LunarEchoo56/LuminaBlossom/enclosure/README.md

# Enclosure Manufacturing Files: LuminaBlossom Programmable Light Display

This folder contains the vector graphics files required to cut out LuminaBlossom's circular wooden base. These files are intended for cutting 3mm birch plywood or basswood. They were tested on an XTool D1 Pro 5W laser cutter/engraver. For your convenience, both the original XTool Studio (.xs) as well as color-coded vector graphics (.svg) files are enclosed.

## Licensing
All design assets in this folder are licensed under the Creative Commons Attribution 4.0 International License (CC BY 4.0).

## Files Included

* `luminablossom.svg` - Universal vector format for use with any laser cutter software (LightBurn, Glowforge, etc.).
* `luminablossom.xs` - xTool Studio project file, including settings used for the photographed prototypes.

## Assembly Instructions

Materials required, prep, and finishing details are available in the `\docs` folder:

* [Complete Assembly Guide](/docs/assembly.md)
