LunarEchoo56/LuminaBlossom/docs/scraps/original_spec.md

# Project Name: **LuminaBlossom** Ambient Light Display

## Functional Requirements Document

## Target Platform: Raspberry Pi Pico 2 W (Pico C SDK / Earle Philhower Core)

## Document Version: 1.1

### 1. System Overview

LuminaBlossom is a network-attached, programmable ambient light display built into a translucent lotus-blossom art piece. The system leverages the Raspberry Pi Pico 2 W (powered by an RP2350 microcontroller) to serve as a headless, Wi-Fi-enabled peripheral. It exposes a local REST API that allows external clients (such as local AI agents, VS Code extensions, or mobile applications) to trigger pre-configured or math-scripted illumination patterns.

### 2. Hardware & Electrical Requirements

#### 2.1 Power Architecture

Input Voltage: 5V DC via a Micro-USB connector.
LED Power Rail: The NeoPixel RGBW LED ring must be powered directly from the VBUS pin (5V line straight from USB power) to support peak current draws up to 1A at full brightness.
Microcontroller Power Rail: The Pico W will be powered via its internal regulator connected to VSYS.

#### 2.2 Physical Escape Hatch (Factory Reset)

The enclosure must feature a precision pinhole perfectly aligned with the Pico's native BOOTSEL button (or a dedicated hardware reset pin).
Behavior: Holding this button down via a paperclip for 5 seconds during operation will clear all stored network configurations from non-volatile memory and reboot the device back into provisioning mode.

### 3. Firmware Architecture & State Machine

The firmware will be written in C/C++ using the native Raspberry Pi Pico SDK and the lwIP (Lightweight IP) stack. To ensure smooth, stutter-free animations, the dual-core architecture of the RP2350 will be utilized.

#### 3.1 Core Allocation

Core 0: Runs the lwIP TCP/IP stack, handles Wi-Fi connections, manages the background HTTP/DNS servers, and parses incoming JSON network packets.
Core 1: Runs the math-based animation execution engine and feeds data to the PIO (Programmable I/O) state machines driving the NeoPixels.
Inter-Core Communication: Thread-safe communication will be handled using the Pico SDK’s hardware FIFO queues (pico/util/queue.h) to pass lighting state changes from Core 0 to Core 1.

#### 3.2 System State Machine

The firmware operates in two runtime modes:

- **MODE_PROVISIONING**
  Active when: no stored credentials, authentication failure, or network unreachable at boot.
  Behavior: Hosts a captive portal Access Point (LuminaBlossom_Setup). Onboard LED blinks slowly. Credentials stored in LittleFS are preserved unless the failure was an explicit authentication rejection (`WL_CONNECT_FAILED`).

- **MODE_CONNECTED**
  Active when: device successfully joins the stored network.
  Behavior: Runs WebServer on port 80, mDNS at luminablossom.local, and the NeoPixel animation engine.

**Boot sequence:**
1. Load credentials from LittleFS.
2. If credentials exist, attempt connection (20-second timeout).
3. On success → MODE_CONNECTED.
4. On authentication failure (`WL_CONNECT_FAILED`) → clear credentials → MODE_PROVISIONING.
5. On network unreachable (timeout, SSID not found) → **keep credentials** → MODE_PROVISIONING. A subsequent power cycle will retry the stored credentials automatically.

**WiFi watchdog (MODE_CONNECTED only):**
If `WiFi.status()` leaves `WL_CONNECTED`, the device reboots after a 30-second grace period, which resets the lwIP stack cleanly and re-enters the boot sequence above. Core 1 (NeoPixel animation) is unaffected during the wait.

**Factory reset:**
Holding the BOOTSEL button for 5 seconds at any time clears stored credentials and reboots to MODE_PROVISIONING.

### 4. Headless Wi-Fi Setup & Provisioning Portal

When the device cannot find valid Wi-Fi credentials in its local storage, it must automatically host a local captive portal setup experience.

#### 4.1 Access Point (AP) Mode

The Pico W will initialize the CYW43439 wireless chip in Access Point mode.
SSID: LuminaBlossom_Setup_XXXX (where XXXX represents the last 4 digits of the chip's unique MAC address).
Security: Open (No password required for initial setup).
Local IP Configuration: Gateway set statically to 192.168.4.1.

#### 4.2 Rogue DNS Server (Captive Portal Enforcement)

A lightweight UDP server must listen on Port 53.
Behavior: The server must intercept all incoming DNS lookups generated by the connecting smartphone or operating system (e.g., Apple's captive network assistant tests) and return 192.168.4.1 as the resolved IP address. This forces the client device to automatically pop open the configuration webpage.

#### 4.3 HTTP Provisioning Web Server

An HTTP server must listen on TCP Port 80.
A catch-all route must serve a single, highly optimized HTML/CSS/JS page embedded directly inside the firmware flash memory as a static byte array.

The page must:
Trigger an async scan of local Wi-Fi networks and display them in a dropdown.
Provide a secure password text field.
Issue an HTTP POST request back to the Pico containing the chosen SSID and Password.

#### 4.4 Non-Volatile Storage (Credentials)

Wi-Fi credentials (SSID and password) are stored in LittleFS at `/wifi_creds.txt` (SSID on line 1, password on line 2). LittleFS occupies a dedicated 2 MB partition of the Pico's flash.

Credential lifecycle:
- Written when the user submits the provisioning form.
- Read on every boot to attempt automatic reconnection.
- **Cleared only on explicit authentication failure** (`WL_CONNECT_FAILED`) or factory reset — never on a simple network-unavailable failure, so a device that loses its network connection temporarily will reconnect automatically on its next boot without requiring the user to re-enter credentials.

Once credentials are saved, the device executes a deferred software reboot (~1.5 s) to transition into the connecting sequence.

### 5. Network Services & Local Discovery (mDNS)

To eliminate the need for users to discover the device's IP address through their router settings, LuminaBlossom must support zero-configuration networking.

mDNS Daemon: The firmware must compile and initialize the lwIP mDNS app layer.
Local Hostname: The device will register on the local network as luminablossom.local.
Service Broadcasting: It will broadcast an _http._tcp service on port 80, allowing local discovery applications, IDE extensions, or agent scripts to automatically resolve its IP address over the network.

### 6. REST API & Interoperability Specification

Once active on the local network, the HTTP server on Core 0 will process incoming commands. All endpoints must parse and return standard JSON payloads.

#### 6.1 CORS (Cross-Origin Resource Sharing) Compliance

To allow web-based dashboards or browser extensions to communicate directly with LuminaBlossom, the HTTP response parser must include the following headers in every response, including handling the pre-flight HTTP OPTIONS method:

HTTP
```
Access-Control-Allow-Origin: *
Access-Control-Allow-Methods: POST, GET, OPTIONS
Access-Control-Allow-Headers: Content-Type
```

#### 6.2 API Endpoints

- POST /api/effect
Triggers an immediate, non-blocking visual effect.
Payload Schema:
JSON
```
{
  "effect": "string",       // Name of the preset handler (e.g., "pulse", "wave", "sparkle")
  "color": "string",        // Hexadecimal string for GRBW values (e.g., "FF000000" for Red)
  "speed": 0.00,            // Floating point modifier for time increments / frequencies
  "duration": 0             // Optional millisecond cutoff (0 for infinite loop until next command)
}
```
Success Response: 200 OK with JSON {"status": "success", "playing": "effect_name"}

- POST /api/save
Saves a custom parameter packet to the internal file storage (using a lightweight library like LittleFS embedded in flash) so it can be referenced later by a custom keyword.
Payload Schema:
JSON
```
{
  "name": "string",         // Keyword to register the effect
  "config": {               // Custom math parameters passed to the engine
    "frequency": 0.33,
    "amplitude": 1.00,
    "wave_type": "sine"
  }
}
```
Success Response: 201 Created

- GET /api/status
Returns the current health, network strength (RSSI), and active lighting pattern of the device.
Success Response: 200 OK with system statistics.

### 7. Lighting Control Engine (High-Level Placeholder)

Animation Player: Core 1 will monitor a shared state structure populated by the REST API.

Math-Scripting Interpreter: When a command is received, Core 1 will use the provided parameters (frequency, wave type, speed modifiers) to compute individual LED brightness matrices on the fly, feeding them continuously into the PIO hardware buffers at a target framerate of 60 FPS. Network calls will not block or hitch these frame calculations.
