LunarEchoo56/LuminaBlossom/docs/pio_state_machines.md

# PIO State Machines: LuminaBlossom Programmable Light Display

As described in the [LED Technical Details](/docs/led_technical_details.md#4-taking-advantage-of-the-pico), our Raspberry Pi Pico 2 has a bank of 12 "Programmable I/O" state machines, or "PIOs." Our hardware is built to control a lot of devices, some of which (like our LED lights!) require specific signal timing. These little state machines are like tiny processors of their own that run independently of the main CPUs. They're perfect for sending messages or instructions between different parts of the computer while our powerful processors are doing something else.

Our LED lights are controlled by a single data line that requires super-specific signal timing, sending a "1" or a "0" every 1.25 microseconds. Any interruption in our data stream might corrupt the data. Rather than use a CPU to babysit the signal, this is a textbook example of what the PIO state machines are made for! In the LuminaBlossom, one of our CPUs (core 1 in this case) calculates the next frame of animation data and drops all of the color information into the PIO's buffer. The CPU is free to move on to other tasks while a PIO state machine dutifully converts the data into a perfectly-timed signal that it sends to the lights, 1.25 microseconds for each and every 1 or 0, until the data is sent.

For more details about how the lights work, see the [LED Technical Details](/docs/led_technical_details.md). In this section, we're going to look at the PIO and how we coded it.

>[!TIP]
>Understanding the PIO state machines is an incredible exercise for a computer scientist! This is pure bits and steel. It's machine-code in action. Learning how PIO state machines work demonstrates how _computers_ work at the lowest level. Let's do it!

---

## Table of Contents

1. [The Hardware](#1-the-hardware)
2. [PIO Machine Language](#2-pio-machine-language)
3. [Our LED Code](#3-our-led-code)
4. [Assembly](#4-assembly)
5. [Getting Started and Further Reading](#5-getting-started-and-further-reading)

---

## 1. The Hardware

To understand what's happening inside the hardware, let's shrink ourselves down to computer-size! Imagine that you are in a small workshop. Looking around, here's what you see:
- A mailbox on the wall for incoming mail
- A mailbox on the wall for outgoing mail
- A simple clock with only one hand and only one number
- A big instruction book, with a bookmark reserved just for you
- A little shelf big enough to hold a number, labelled "Scratch X"
- An identical little shelf labelled "Scratch Y"
- One or more Big Important Switches on the back wall
- A Very Important bright red telephone labelled "IRQ"

                ┌──────────────────────────────────────────────────────────────────────────────────┐
                │ \                                                                              / │
                │  ┌────────────────────────────────────────────────────────────────────────────┐  │
                │  │                                                                            │  │
                │  │  <== TO CPU                                              TO GPIO PINS ==>  │  │
                │  │                                                                            │  │
                │  │                                  _______                                   │  │
                │  │                                 ( CLOCK )                                  │  │
                │  │                                  -------                                   │  │
                │  │                                                                            │  │
                │  │   ┌──────┐   ┌──────┐                                                Big   │  │
                │  │   │INBOX │   │OUTBOX│                          │X Scratch           Switch──┐ │
            Red │┌─┐   │      │   │      │                          ├──────────               │ │├─┴────
            Phone│IRQ  ┌──────┐   ┌──────┐    Instruction   YOU     │Y Scratch               /│ ││ GPIO
                │└─┘   └──────┘   └──────┘       Book     (A PIO)   └───────────            O │ │├─┬────
                │  │                          ┌─────────┐    o                                └──┘ │
                │  └──────────────────────────└─^───────┘───└█┘─────────────────────────────────┘  │
                │ /                            Bookmark     / \                                  \ │
                │/                                                                                \│
                └──────────────────────────────────────────────────────────────────────────────────┘

Congratulations, you're a PIO state machine! Your job is super-simple. The clock is spinning at a constant rate. Whenever it dings, you go to the instruction manual, execute the instruction given at your bookmark, then scoot your bookmark forward to the next instruction. There are less than a dozen possible instructions, and every instruction is SUPER simple, like:

- "Grab a number from your inbox and put it onto the Scratch X shelf."
- "Move your bookmark to a different page."
- "Copy the contents of Scratch Y to your Out-box."
- "Pick up the Red IRQ Phone and push 0!"

As a PIO, you're not even expected to do _math!_ For the most part, you pretty much just conditionally move data around and flip switches.

**PIOs Operate Independent of the CPU**

From the perspective of the computer, every PIO workshop is self-operating. The CPU drops off the instruction book, sets the bookmark, sets the clock speed, and then leaves the PIO alone to run those instructions until someone tells it to stop or the computer blows up.

The giant red "IRQ" phone is an exception, used for communicating directly between the PIO and CPU. "IRQ" stands for "Interrupt Request" and the CPU can be programmed to drop whatever it's doing and handle that request immediately. This is expensive and potentially disruptive to the CPU, which is why I describe it as a red phone. The phone works both ways - the CPU can make the phone ring, and the PIO will respond _if its instructions call for it._ One example might be "wait here until the red phone rings," or "jump to this instruction if the red phone is ringing."

**PIOs Directly Operate the GPIO Pins**

What I described as "important switches on the back wall" are the GPIO ("General-Purpose Input/Output") pins of the Raspberry Pi Pico 2W. The Pico is a microcontroller, which means its job is to control stuff. In this case, we're controlling a string of LED lights from GP16 (pin 21 on the corner of the device - See the [Wiring Guide](/docs/assembly.md#6-wiring-the-pico-2w)). Our PIO will flip this switch "on" and "off" to send color data out to the LEDs. In our setup, _only_ the PIO has access to this pin. If we want the lights to do something, we need to tell the PIO!

Our "LED Controller" PIO program is very simple and only uses one pin: It'll read data one bit at a time from the inbox, then toggle the LED data pin on and off with exact timing. It's a super-simple job, and our little machine will do it non-stop. 32 bits of data per light, times 16 lights, 60 times a second... That's 30,720 bits of data processed every _second_. Go little machine, go!

---

# 2. PIO Machine Language

Let's take a close look at what I described as a big "instruction book" with a personal bookmark. As with everything else in a computer, the instructions are saved as a bunch of ones and zeroes, stored in memory. What I described as a "bookmark" is called the "Program Counter," and it's really just a pointer to the memory address of the instruction you're on.

Think _small_. The entirety of the instruction book is only 64 bytes. That's 512 bits. This paragraph of text is more than twice that size!

Every complete instruction for the PIO is represented in only 16 bits. Below you'll find a table of all the possibilities, and how the 16 bits are used. As you can see, every single 1 or 0 makes a difference! There's a whole 5-bit section (called "Delay / Side-set") that we can customize to squeeze even more operations out of every bit:

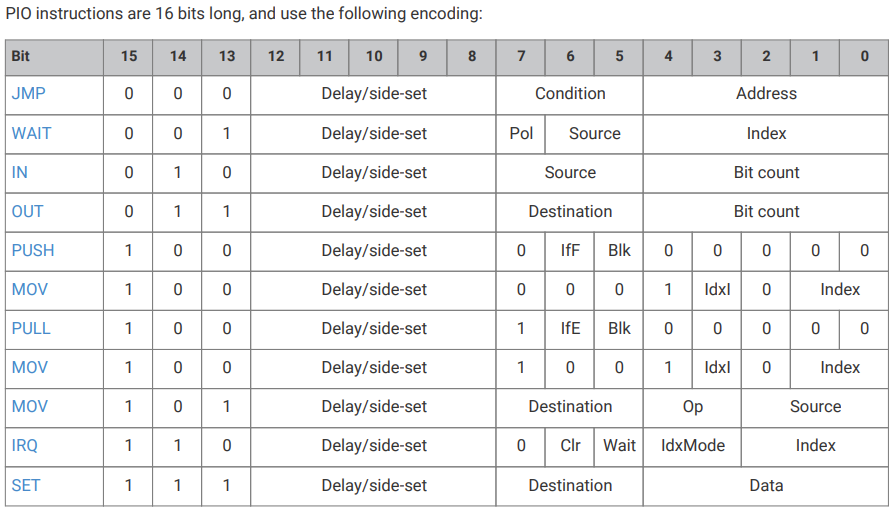
[picture p12: docs/images/pio_instructions.png]
PIO State Machine Instructions


Don't sweat all the details yet - learning all of these instructions and how they work would make you a true machine language programmer! The really important thing to understand right now is _how_ it works: The PIO uses just a few ones and zeroes to perform any action. Let's just look at one example!

PIO State Machine "Wait" Instruction

Your PIO starts reading an instruction and sees that the first three bits are "001." That means "Wait," so the remainder of the bits are going to tell the PIO how long to wait and what to wait on. The next five bits are customizable when we set up the machine, we'll talk about them in a second. The next bit (labelled 7) stands for the "polarity" - in other words, are we waiting for a 1? Or are we waiting for a 0? Bits 5 and 6 together tell us the "source" we're waiting on. For instance, if these two bits are "00" that means we're waiting on one of the GPIO pins, and the next five bits (labelled 0-4) will tell us which one. If bits 5 and 6 are "10" that means we're waiting on an IRQ (in our analogy above, this is like checking the status of the "Red Phone" to the CPU...)

How do we know this stuff? Each and every bit is labelled and described in the [Datasheet for our CPU](https://datasheets.raspberrypi.com/rp2350/rp2350-datasheet.pdf). It takes about a page to describe the workings of each instruction.

## Customizing Your Instructions: Delays and Side-Sets

When we first set up a PIO state machine, in addition to writing the instruction book and setting the clock speed, we can also tell the machine how to interpret those five "Delay / Side-Set" bits.

By default, all five bits are used to calculate a delay - that is, a number of cycles the machine waits after completing the instruction before moving on to the next one. Five bits can hold a number between 0 and 31 - in other words, if all the bits are 0s, we don't delay at all, and execute the next instruction on the next clock cycle. If all five bits are 1s, then we delay 31 cycles before advancing.

>[!Tip]
>Since we can set the clock timing to whatever we want (up to the clock speed of the CPU), we can precisely time our delays. Even without overclocking the Pico 2W we can set the clock cycles to be as fast as 6.7 _nanoseconds_ per tick. These machines are built to be fast and precise!

But if we don't need a full 31-cycle delay anywhere in our program, we can sacrifice some of those "delay" bits to "side-set" a pin. The engineers who designed the system thought about it this way: One of the most important things a PIO will do is toggle a GPIO pin on or off. Rather than waste a full instruction every time we want to do that, we assign some of those bits to setting a pin on or off in addition to whatever the main instruction is. Hence the name, "side-set."

By establishing a side-set pin when you initialize a state machine, you can "double-up" your instructions. For example, "JUMP here (and also turn the pin on)", "MOVE this (and turn the pin off)." Our state machine only has the memory for 32 instructions, so by packing in the instructions like that we can maximize the effectiveness of every bit.

## Now You're Speaking Machine!

Obviously it would take a long time to explain every bit of every instruction, but if you understand the concept, you have just learned how computers work at a fundamental level. Your state-of-the-art desktop CPU uses more than 16 bits per instruction, but it still processes instructions with each cycle. It has a great many more operations it can do, and scratch registers to do them on, but it's still moving numbers around between registers and into or out of memory. Any non-quantum computer _fundamentally works the same way as a PIO state machine_, converting _bits_ into _instructions_ and doing them according to a set clock cycle.

If you understand what's happening down there in binary, you understand the very principle of how computers operate. Congratulations! In this day and age of vibe-coding, very few humans actually comprehend what's going on at this machine level, and fewer still know how to program there.

>[!Note]
>That's why I wanted to make sure PIO-coding was a part of this project. These little machines are a perfect demonstration of machine code in action, and you can play around in this space on a computer that costs less than a cheeseburger combo.

---

# 3. Our LED Code

As we've seen in the [LED Technical Details](/docs/led_technical_details.md), we're using "SK6812" RGBW LEDs, which share the same data/timing specs as "WS2812" LEDs. That means our LEDs are programmed via a single data line that must transmit bits at a fixed clock speed. If we listened in on the data line while it was transmitting, an oscilloscope would show something like this:

                        One bit is sent every 1.25 microseconds.
    │          Divide that time into 10 "Cycles" of .125 microseconds each.        │
    ├──────┬───────┬───────┬───────┬───────┬───────┬───────┬───────┬───────┬───────┤
    │      │       │       │       │       │       │       │       │       │       │

                  A "1" is a HIGH pulse of 7 cycles and a LOW pulse of 3.
    │███████████████████████████████████████████████████████       │       │       │
    ├──────┬───────┬───────┬───────┬───────┬───────┬───────────────┴───────┴───────┤
    │      │       │       │       │       │       │        ███████████████████████│

                  A "0" is a HIGH pulse of 2 cycles and a LOW pulse of 8.
    │██████████████        │       │       │       │       │       │       │       │
    ├──────┬───────────────┴───────┴───────┴───────┴───────┴───────┴───────┴───────┤
    │      │       ████████████████████████████████████████████████████████████████│

                              Here's another way to look at it:

    │ Always High  │       DATA: High for 1, Low for 0     │      Always Low       |
    │██████████████│░░░░░░░│░░░░░░░│░░░░░░░│░░░░░░░│░░░░░░░│       │       │       │
    ├──────┬───────┼───────┼───────┼───────┼───────┼───────┼───────┴───────┴───────┤
    │      │       │░░░░░░░│░░░░░░░│░░░░░░░│░░░░░░░│░░░░░░░│███████████████████████│

Put simply, the PIO just has to flip the data pin on or off and wait a specified period of time. For each bit, we flip the data line HIGH for two cycles. If the bit is a "1" we keep the data line HIGH for the next five cycles, whereas for a "0" we turn the data line LOW for five cycles. In either case we set the line LOW for the final three cycles, and then begin again.

My original PIO code is below. The header and comments are in MicroPython format, but what you want to pay attention to are the last 9 lines. Those are written in "Assembly," a kind of human-readable shorthand for machine code. (Technically it's a python-readable syntax of assembly.)

    @rp2.asm_pio(sideset_init=rp2.PIO.OUT_LOW, out_shiftdir=rp2.PIO.SHIFT_LEFT, autopull=True, pull_thresh=32)
    def neopixel_projector():
        """
        Waits for a stream of colors from the main program and sends them to the
        NeoPixel with precise timing. WS2812B timing constants: Each "pulse" is
        0.125 microseconds (us). Total signal is 10 pulses / 1.25 us.
        Run this machine at 8MHz (freq=8000000) for microsecond-perfect timing!
        """
    # To send a "1", we need a high pulse of 7 cycles (2 + 5) and a low pulse of 3 cycles (3).
    # To send a "0", we need a high pulse of 2 cycles (2) and a low pulse of 8 cycles (5 + 3).
    # Each bit will always last 10 cycles (2 + 5 + 3).

    wrap_target()                           // Start here
    label("bitloop")                        // Jump target "bitloop"
    out(x, 1)               .side(0) [2]    // Grab the next bit, put it in "X". Pin: LOW, delay 2
    jmp(not_x, "do_zero")   .side(1) [1]    // Jump to "do_zero" if X is zero. Pin: HIGH, delay 1
    label("do_one")                         // Label. We're outputting a 1 next line
    jmp("bitloop")          .side(1) [4]    // Jump back up to "bitloop." Pin: HIGH, delay 4 [Data]
    label("do_zero")                        // Jump target "do_zero." We're outputting a 0 next line
    nop()                   .side(0) [4]    // Do nothing... But: Pin: LOW, delay 4 [Data]
    wrap()                                  // Go back to start

If we focus on the assembly code, we see at least half of it is labels and jumps. The line where the rubber meets the road is this one:

    out(x,1)                .side(0) [2]

It says, "grab exactly 1 bit from the 'Output shift register' and put it into our 'x register.'"

>[!TIP]
>The Output Shift Register is one of those mailboxes that I described earlier. The MicroPython header at the top ("out_shiftdir=rp2.PIO.SHIFT_LEFT, autopull=True, pull_thresh=32") defines how our PIO should handle its mailbox: Every time we run out of bits we grab 32 more.

Many lines in the code say ".side(0)" or ".side(1)". This is that sweet side-setting functionality described above: When we start our PIO machine, we'll tell it that its side-set pin is the data line for our lights. .side(1) sets the line high, .side(0) sets it low.

A number in brackets also appears in many lines. This is the number of cycles to delay _after_ executing the instruction. Note that it always takes _one_ cycle to perform an instruction, so to wait for exactly five cycles we would run an instruction and then delay four. This is what happens in the "do_one" or "do_zero" section of the code: We set the pin to high or low, then delay 4 cycles (for a total time of 5).

See if you can follow along with the code as it processes either a 1 or a 0!

---

# 4. Assembly

We have our list of instructions above written in a (python-readable) shorthand called "Assembly Language." For it to run on our PIO state machine, we have to convert those instructions into the binary 1s and 0s that we talked about in [Section 2](#2-pio-machine-language). Every instruction has to be converted into 16 bits, and every label/jump destination has to be converted into a relative memory address. We call this process "Assembly" and the programs that do it "Assemblers."

The PIO state machines are simple enough that we can imagine doing this by hand. The relevant section of the [RP2350 Datasheet](https://datasheets.raspberrypi.com/rp2350/rp2350-datasheet.pdf) is only about a dozen pages. Similar to the way we broke down the "WAIT" instruction above, you could figure it out, line-by-line, one 16-bit instruction at a time. Once you take out all the jump targets or labels, you really only have about 4 lines of code. It's an interesting exercise for a student. It takes you back to a time when programs were entered into the front panel of a computer by manually flipping switches! But as you'd imagine, nobody really "hand assembles" anything anymore.

The designers of the Raspberry Pi Pico 2W provide an SDK that includes something called the "pioasm" (PIO Assembler). This takes raw assembly code and outputs a C header (.h) file with the complete machine configuration and code. Using this, your C program can initialize a PIO state machine with ease. Other people have written other tools that do the compiling for you: the code above was written in MicroPython. MicroPython (and the related CircuitPython language) can assemble that code on the fly and upload it to your PIO when needed.

Recently, there's another way to get our final code, thanks to large language model AI. Converting this stuff to binary is a walk in the park for an advanced model, and a frontier model can convert the MicroPython code above in a single pass. The results:

    static const uint16_t ws2812_program_instructions[] = {
        //        Instruction                side  delay
        0x6221u,  // out x, 1               0     2     (pin LOW  for 3 cycles)
        0x1123u,  // jmp !x, 3  → do_zero   1     1     (pin HIGH for 2 cycles; !x = condition 001)
        0x1400u,  // jmp 0  (do_one→bitloop)1     4     (pin HIGH for 5 cycles)
        0xa442u,  // mov y, y (nop/do_zero) 0     4     (pin LOW  for 5 cycles)
    };
    static const pio_program_t ws2812_program = {
        .instructions = ws2812_program_instructions,
        .length       = 4,
        .origin       = -1,
    };

Nobody but the computer would ever need to look at that code in binary, but for super-fun (yeah, fun!) here's what that looks like in raw 1s and 0s:

    0110 0010 0010 0001     // out x, 1     0 2 (pin LOW for 3 cycles)
    0001 0001 0010 0011     // jmp !x, 3    1 1 (pin HIGH for 2 cycles)
    0001 0100 0000 0000     // jmp 0        1 4 (pin HIGH for 5 cycles)
    1010 0100 0100 0010     // nop          0 4 (pin LOW for 5 cycles)

Those 64 bits are _everything_ your PIO needs to know in order to send color data to your lights with micro-second precision timing. What a little miracle!

## Revving Up the Machine

The PIO hardware will just sit there until a CPU tells it to go. As we pointed out above, the CPU needs to set up a few things before turning that sucker loose: What are the instructions? Which instruction should it begin at? How fast should the clock cycle be? What pins are the machine connected to? How do we handle those 5 customizable delay/sideset bits? And if we're using sideset, which pin is it setting? How should it handle the inbox and the outbox?

The exact mechanics for doing all of this vary by language, and it can be extremely fiddly. In our .cpp program it's about 15 lines of code. Let's walk through it in order, starting from when the machine boots up and starts to execute `main.cpp`. The first thing Core 1 does is call initLEDs(), located in `led_controller.cpp`:

    void initLEDs() {
        // Determine "Offset," the start of our program.
        uint offset = pio_add_program(_pio, &ws2812_program);   // Add our program, note the address
        _sm = (uint)pio_claim_unused_sm(_pio, true);            // Use first available state machine
        ws2812_sm_init(_pio, _sm, offset, LED_PIN);             // Call Init function w/ our program

        _ledsEnabled = true;
    }

 Those first lines of code tell the PIO which program its going to run and calculate where the program is located (the "Offset.")

>[!TIP]
>Up to four state machines can share the same 64-byte "instruction book." It's possible to have all four machines running the same code, or it's possible to divide up the instruction book into multiple chunks and have each machine run its own code. In order for this to work, when you initialize a state machine, you have to tell it which instruction (or "page of the book") it's supposed to start on - in the code, we call this the "offset."

The data for our code is saved as "ws2812_program." We load it into our PIO data bank and note the offset. The next line claims the first unused state machine available and saves it as _sm ("state machine.") The last line calls a longer ws2812_sm_init() function to handle the nitty-gritty configuration and start the machine.

Here's what that code looks like:

    // ── PIO state machine initialization ──────────────────────────────────────────
    static void ws2812_sm_init(PIO pio, uint sm, uint offset, uint pin) {
        pio_gpio_init(pio, pin);
        pio_sm_set_consecutive_pindirs(pio, sm, pin, 1, true);  // pin is output

        // Start with Default Config and adjust for our sideset bits and data length
        pio_sm_config c = pio_get_default_sm_config();
        sm_config_set_wrap(&c, offset, offset + 3);           // wrap_target=0, wrap=3
        sm_config_set_sideset_pins(&c, pin);
        sm_config_set_sideset(&c, 1, false, false);           // 1 sideset bit, not optional
        sm_config_set_out_shift(&c, false, true, 32);         // shift left, autopull at 32 bits
        sm_config_set_fifo_join(&c, PIO_FIFO_JOIN_TX);        // 8-word TX FIFO

        // 8 MHz for WS2812-compatible timing (matches Python reference)
        float div = (float)clock_get_hz(clk_sys) / 8000000.0f;
        sm_config_set_clkdiv(&c, div);

        // Initialize machine and start it up!
        pio_sm_init(pio, sm, offset, &c);
        pio_sm_set_enabled(pio, sm, true);
    }

Essentially, we start with the default state machine configuration (pio_get_default_sm_config()), then make a few adjustments to let it know how big our program is, when it should wrap, which pins we're going to use, how we handle the five delay/side-set bits, and how we handle our mailboxes . We also set the machine to run at 8 MHz (to get the exact cycle timing for our lights). Finally, the last two lines initialize the state machine and turn it on.

If you follow the code, you can see that this is the _very_ first thing that CPU Core 1 does on start up. Sure enough, when you plug in your LuminaBlossom, note that the lights _immediately_ turn on. Our PIO state machines are running and our LEDs are operable pretty much from the instant we boot. Technology is cool!

---

# 5. Getting Started and Further Reading

Hopefully the above explanation gives you an idea of how the LuminaBlossom uses the PIO hardware to update its LEDs. These PIO state machines are simple processors, and they're really fun to play with, but you can see they require quite a bit of setup and tinkering. Don't be intimidated! The important thing is to understand _how they work_ and _what they're used for._ With that background, you should be able to crib together the functionality you need by working from existing examples or working with AI.

## Repositories of PIO Programs

* [Official Raspberry Pi PIO Sample Programs](https://github.com/raspberrypi/pico-examples/tree/master/pio/) - This well-documented collection of PIO utilities demonstrate their many uses, such as this straightforward [Squarewave Example](https://github.com/raspberrypi/pico-examples/tree/master/pio/squarewave).
* [Raspberry Pi WS2812 LED Implementation](https://github.com/raspberrypi/pico-examples/tree/master/pio/ws2812) - As you might imagine, LuminaBlossom's LED driver is based off of this. It should look pretty familiar. Good programmers copy; _Great_ programmers copy _and_ paste!

## Official Documentation

* [RP2350 Datasheet](https://datasheets.raspberrypi.com/rp2350/rp2350-datasheet.pdf) - The RP2350 is the CPU we're using. The PIO state machines are explored in extensive depth starting on page 876.
* [Raspberry Pi C/C++ SDK](https://pip-assets.raspberrypi.com/categories/609-microcontroller-boards/documents/RP-009085-KB-2-raspberry-pi-pico-c-sdk.pdf) - The complete SDK has a whole section explaining the PIO and how to code it, starting on page 35.

## Helpful Community Resources

* [LuminaBlossom's LED Technical Details](/docs/led_technical_details.md) - More about this topic from the perspective of the LED hardware and what it does with the signal we generate above.
* [Cornell University: _Digital System Design with Microcontrollers_ Course](https://ece4760.github.io/) - Professor Hunter Adams has a wonderful series of lectures and guides from Cornell posted online. It's an exceptional resource for makers.
* [Wokwi Raspberry Pi Pico Simulator](https://wokwi.com/pi-pico) - Play with a virtual Pico in your web browser! Among the many projects there's even a [Simulation of a 16-light LED Ring](https://wokwi.com/projects/314265138001609280) very similar to the LuminaBlossom. You can even click on the "PIO" tab to watch the PIO code in action.
* [Gary Explains the PIO State Machines](https://www.youtube.com/watch?v=QlKtEA5XKc4) - A friendly video explanation of the above material, with lots of examples of PIO in action.
