LunarEchoo56/LuminaBlossom/docs/assembly.md

# Physical Assembly Guide: LuminaBlossom Programmable Light Display

Building your own LuminaBlossom from scratch? Great idea! This is the perfect starter/intermediate electronics and woodworking project. All of the files you need are in this repository, and all of the hardware and skills you'll need are listed below.

---

## Table of Contents

1. [Bill of Materials](#1-bill-of-materials)
2. [Workbench Equipment](#2-workbench-equipment)
3. [Manufacturing the Case](#3-manufacturing-the-case)
4. [Prepping the Lights and Spindle](#4-prepping-the-lights-and-spindle)
5. [Prepping Your Artwork](#5-prepping-your-artwork)
6. [Wiring the Pico 2W](#6-wiring-the-pico-2w)
7. [Final Assembly](#7-final-assembly)

---

## 1. Bill of Materials

| Item | Qty | Est. Price (USD) | Vendor Ideas | Notes |
| :--- | :---: | ---: | :--- | :--- |
| **Raspberry Pi Pico 2W** | 1 | $7.00 | [Adafruit](https://www.adafruit.com/product/6087) [Microcenter](https://www.microcenter.com/product/687384/raspberry-pi-pico-2-w) | Our heroic microcontroller! Make sure to get the "2W." |
| **Adafruit NeoPixel Ring (16-pixel) RGBW** | 1 | $11.95 | [Adafruit](https://www.adafruit.com/product/2854) | Beautiful pre-assembled circular array of RGBW LEDs. I prefer warm-white. |
| **SN74AHCT125N DIP-14 buffer IC** | 1 | ~$0.75+ | [TI datasheet](https://www.ti.com/lit/ds/symlink/sn74ahct125.pdf) | Through-hole buffer used on the new carrier PCB. |
| **330 Ω axial resistor** | 1 | ~$0.10+ | General component | R1 series resistor between U1 output and LED DIN. |
| **100 nF ceramic capacitor** | 1 | ~$0.10+ | General component | C1 bypass capacitor near U1 supply pins. |
| **470 µF / 10 V radial capacitor** | 1 | ~$0.50+ | General component | C2 bulk capacitor near LED output; observe polarity. |
| **Two-layer carrier PCB** | 1 | Varies | [KiCad source](../hardware/kicad/luminablossom_carrier.kicad_pcb) | Rev A draft only; no Gerbers yet. |
| **Female 1×20 socket strip, 2.54 mm** | 2 | Varies | General component | Two Pico socket rows, 17.78 mm spacing. |
| **Male 1×3 header, 2.54 mm** | 1 | ~$0.10+ | General component | LED output: +5 V, GND, DIN. |
| **Capiz-Shell Decorative Lotus Art** | 1 | ~$10.00+ | (See notes) | Any decorative tea-light holder will work; See notes below for sourcing the beautiful capiz-shell assembly shown.  |
| **50mm Frosted-Glass Cabochon** | 1 | ~$1.50+ | [Amazon](https://www.amazon.com/dp/B07JKZP1Z6) | This acts as a diffuser to bounce our LED lights around; a 50mm translucent acrylic circle is an inexpensive alternative. |
| **3mm (1/8-in) Basswood or Birch Plywood** | 1 | ~$4.00 | Local Lumber / Craft Store | You'll need roughly 8"x12" of wood for laser cutting the case. |
| **Micro-USB Cable (3ft to 6ft)** | 1 | ~$3.00 | Generic / Amazon [Example](https://www.amazon.com/Charging-Transfer-Android-Trustable-MYFON/dp/B098DW7485/) | For power and programming. Ensure it's a data cable, not just power! |
| **5V 1A USB Power Adapter** | 1 | ~$8.00 | Generic / Amazon [Example](https://www.amazon.com/Certified-Charger-Universal-Portable-Adapter/dp/B017TXGM4I/) | Standard phone charger wall brick to power the LuminaBlossom independent of a computer. |
| **M2 Screws (6mm)** | 4 | $.40 | [Amazon](https://www.amazon.com/HVAZI-Metric-Notebook-Computer-Assortment/dp/B075C6C4YR/) / [McMaster-Carr](https://www.mcmaster.com/91698A202/) / [MicroConnectors](https://www.microconnectors.com/assorted-laptop-screws-set-250-pcs-scw-250lp/)| For securing the Pico 2W to the wooden base. |
| **#6 Wood Screws (1/2in)** | 3 | $.75 | [Amazon](https://www.amazon.com/TPOHH-Stainless-Phillips-Threaded-5x12SS18-8/dp/B092Q87W39/) / [McMaster-Carr](https://www.mcmaster.com/90031A552/) | For fastening the two halves of the base enclosure. |
| **Rubber Feet (Self-Adhesive)** | 3 | $1.00 | [Adafruit](https://www.adafruit.com/product/550) [Amazon](https://www.amazon.com/dp/B074PXFWPK/ref=twister_B092W7TL7Y) | These little guys really elevate your build. (Looks directly at camera.) |
| **TOTAL ESTIMATE** | | Recalculate | | *The previous estimate predates the carrier PCB, buffer IC, resistor and capacitors; check current supplier prices.* |

>[!TIP]
>**Sourcing a Tea-Light Holder**:
>The capiz-shell design pictured here is available from [World Market](https://www.worldmarket.com/p/capiz-20-petal-lotus-tealight-candle-holder-119956.html). These are crafted in the Philippines from local materials and look great. Anything designed for a 4cm tea-light candle should work. Try to find something with a lot of translucent surfaces for the light to play off of. Look around and see what "LuminaBlossoms" for you!

---

## 2. Workbench Equipment

To construct this project from scratch, you'll need the skills and equipment to laser-cut and prepare wood, and to solder wires onto circuit boards. If you've never done those things before, this is a _great_ project for getting started! Here's what you should have on-hand:

1. **A 5W (or Greater) Laser Engraver/Cutter.** For the best results, you'll want an air assist and a honeycomb workbench panel. A more powerful laser will cut the project faster, but a little 5W will do.

2. **Wood Prep Materials.** Wood glue and clamps are essential, but for a really pro look and feel you'll also want sandpaper (200 and 400 grit), your color choice of stain, and your choice of finish.

3. **A Soldering Iron Station.** Work in a well-ventilated area, preferably with a heat-resistant mat to protect your work surface. We're only soldering 6 connections, but they're very small: a magnifying glass and "helping hands" to hold the material will really help.

4. **Adhesive.** You'll want a way to attach the wooden parts of the LuminaBlossom to the art piece - little bit of Gorilla Glue will do the trick here. Optionally, a hot-glue gun is terrific for attaching and running hidden wires.

5. **(Optional) Metal-Drilling Equipment.** If you need to run wiring through your lighting display, you may want to drill a hole. _Use caution when drilling metal!_ Wear gloves and goggles, secure the art well, and use a stepped drill bit. LuminaBlossom needs only three small wires, so rather than risk damaging your art (or yourself!), you may just want to discretely run the wires.

---

## 3. Manufacturing the Case

The files you need for cutting and engraving the wooden case and lighting spindle are located in the `\enclosure` folder.

The Enclosure Before Prep and Assembly

Essentially, we're cutting out a "six-pack" of wooden disks. We'll glue three of these together to form the bottom half of the base with pre-printed instructions. The other three layers will be glued together to form the top half of the base, which holds the heart of the project: the blossom artwork, the lighting spindle, and the microcontroller. Once assembled and wired, we will screw both halves together to enclose the hardware and wires in a small hollow cavity.

1. **Download the Design.** Download the correct files for the hardware you're using.

- `\enclosure\luminablossom.svg` is a general-purpose file in "scalable vector graphics" format, or .svg. Import these files into your tool of choice (like LightBurn or Glowforge) and make sure your settings are correct (cut red lines, score blue lines, engrave black lines.) The .svg file features a friendly calibration cube that you can use to ensure you're cutting exactly the right size.

- `\enclosure\luminablossom.xs` is the "xTool Studio" file used for the original design and the prototypes made in the photographs. If you're using xTool hardware and like using their proprietary software, this is the file you want. The machine used was an xTool D1 Pro with a 5W laser. The settings for 3mm birch plywood should already be configured in this file, but you should still double-check the settings and scale for your machine.

2. **Laser-Cut Your Material.** The pictured build uses 3mm (1/8") birch plywood. Do some tests to make sure your configuration is spot-on.

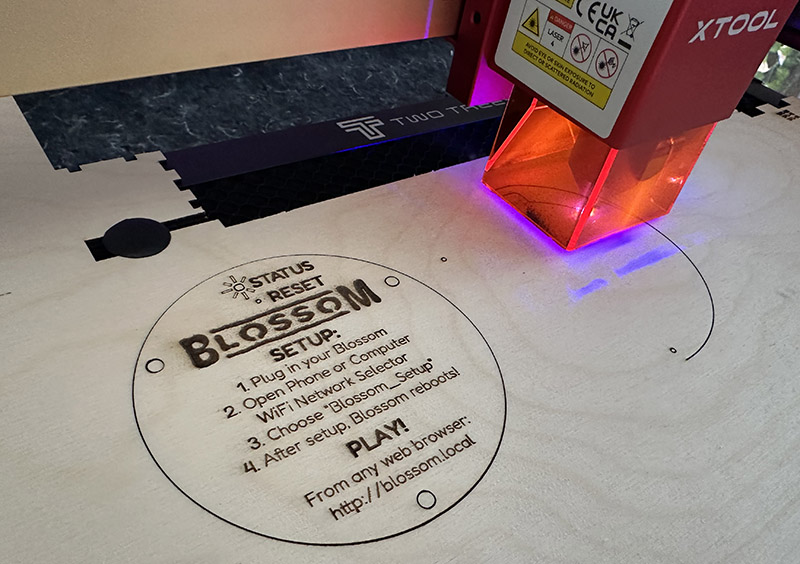
[picture p14: docs/images/laser_cutting.jpg]
Laserin'!


 You're looking for:

- Clean cuts all the way through the wood without scoring.
- An "Engrave" setting that burns in, with high contrast, things like the logo and the headers
- A "Score" setting that burns a nice clean high-contrast line without scorching the wood.

Ensure your tea-candle holder/art display fits into the round holes on top - it's easier to sand and adjust that now than it will be after assembly.

3. **Glue!** Glue the three top pieces together, making sure the nicest wood-grain you have is facing up for the top ring. Align the screw-holes and glue the bottom three pieces together, ensuring that the instructions face down. It's easy to mix up or invert these pieces, so double-check before you glue.

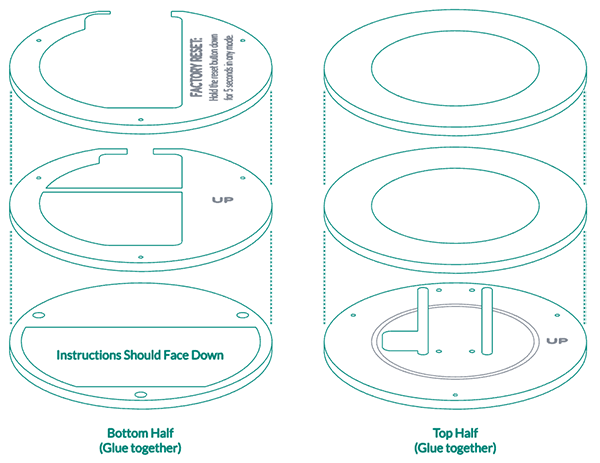
[picture p15: docs/images/assembly_01.png]
Assembling the Two Halves


4. **Sand!** When the glue is dry, screw the top and bottom half together and then sand the exterior. Really smooth it out! You want to remove all the char from the sides of the wood and bevel the edges until your device is smooth to the touch.

5. **Stain!** Once smooth, unscrew both halves and stain them. Remove the instruction insert before staining to get a nice two-tone finish. I prefer a dark stain: The pictured build uses Varathane Classic Penetrating Wood Stain in Red Oak. Glue the instruction insert back onto the bottom after the stain dries.

6. **Finish!** If you want your wood to feel silky smooth and look professional, hit it with some finish! I like Danish Oil for a natural feel. Generously rub the oil onto all the exterior surfaces. I usually use a couple coats. It'll feel a little sticky for a day or so as the oil seeps into the wood; just keep handling it and soon the wood will be soft and smooth with just a hint of gloss.

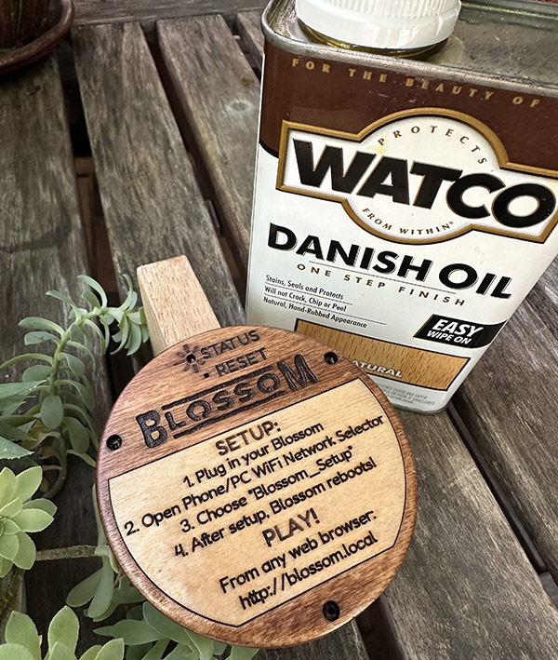
[picture p16: docs/images/assembly_danish_oil.jpg]
Finishing with Danish Oil.


---

## 4. Prepping the Lights and Spindle

With the case assembled we're almost ready to turn our attention to the electronics. We use a spindle and a glass cabochon to elevate and diffuse the lights. Before gluing the spindle together, solder three short wires onto your NeoPixel ring: 5V, Ground, and Data. There are three labelled notches in the spindle that will fit the wires. There's not a lot of room to work with on the ring without damaging the lights, so solder carefully!

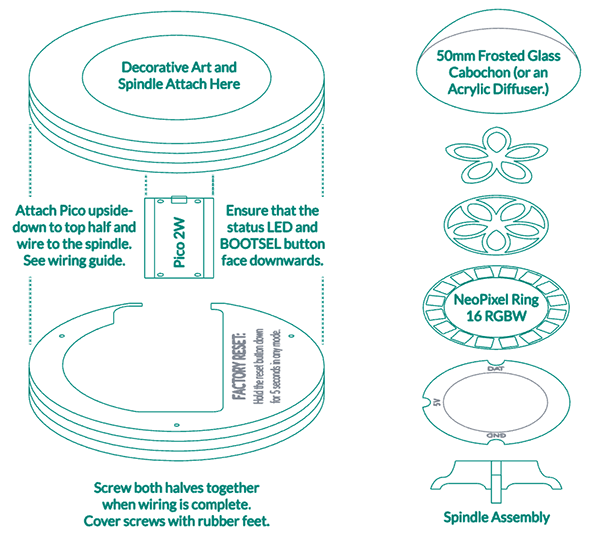
[picture p17: docs/images/assembly_02.png]
Assembling the Two Halves and the Spindle.


> [!TIP]
> **Options for the Diffuser:**
> It's hard to find frosted glass. I buy clear glass cabochons and then use a Rustoleum frosted glass spray (2 coats) to give them a translucent surface with some cool patterns. A translucent 50mm acrylic disc would also do the trick. A capiz-shell insert could be a beautiful solution.

Once your wires are in place you can start to glue together the spindle as pictured above (The pattern contains an extra spindle piece if you need it.) If you're feeling fancy you can use some hot-glue to neatly run the wiring. I've found Gorilla Glue is best for mounting the glass cabochon onto the wood.

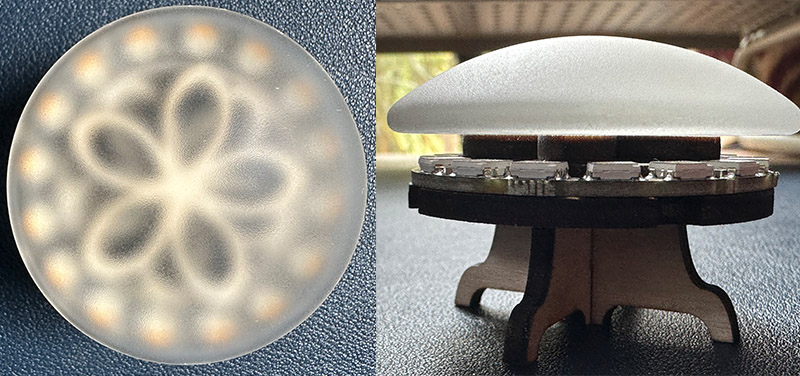
[picture p18: docs/images/assembly_spindle.jpg]
Spindle Top and Side Views


---

## 5. Prepping Your Artwork

Consider how you want to get the wiring from the spindle down to your Raspberry Pi Pico in the enclosure. For this project I use capiz-shell tea-candle holders with a metal base. I drilled a small hole in the bottom of the candle holder about a centimeter from the edge - just enough to fit three wires and line up with the gap cut into the enclosure. Drilling holes in finished art is risky, so I'll repeat a warning from earlier:

> [!CAUTION]
> **Use Care When Drilling Metal:**  Wear gloves and goggles, secure the art well, and use a stepped drill bit. Rather than risk damaging your art (or yourself!), you may just want to discretely run the wires on the outside.

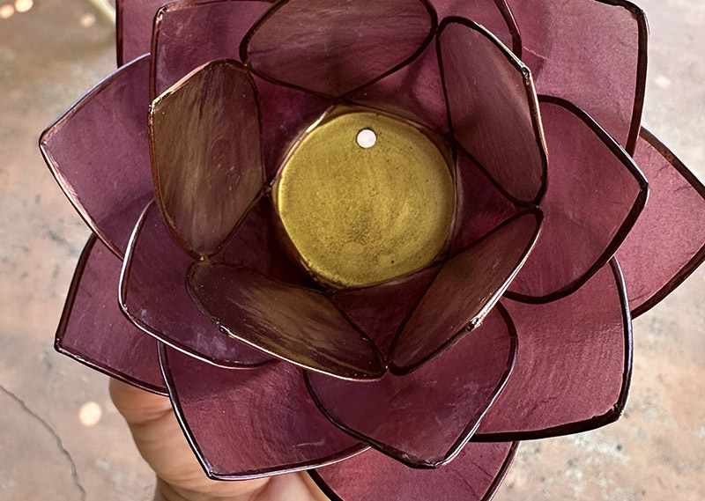
[picture p19: docs/images/assembly_art_prep.jpg]
A hole drilled into the artwork, ready for wiring.


Three wires need to pass through. In the piece pictured above, I drilled a hole about 6mm (quarter-inch).

Our objective is to glue the spindle to the artwork, and the artwork to the enclosure, with three wires passing all the way through. See the photo below. It's starting to smell pretty exciting in here, because it's time to install our state-of-the-art computer core!

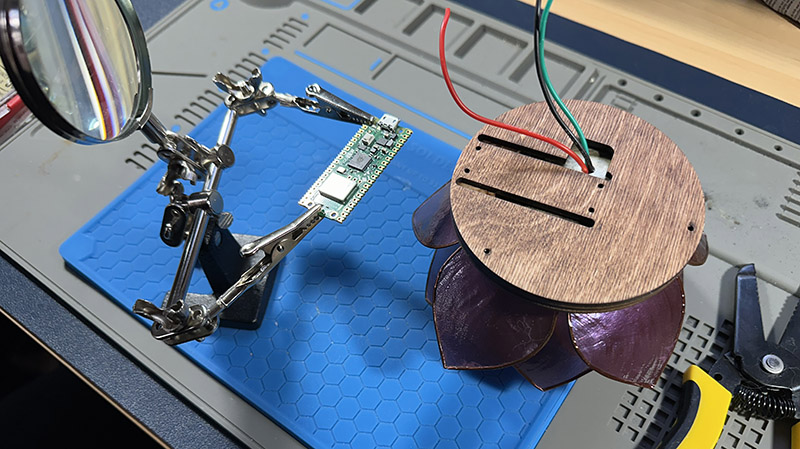
[picture p20: docs/images/assembly_03.jpg]
High-Tech Computer Core Awaiting Insertion.


---

## 6. Wiring the Pico 2W

If you've never soldered anything onto a PCB before, now's the time to learn. This project requires soldering only six connections, and if you've already wired your lights and spindle, you're halfway there.

LuminaBlossom carrier wiring reference

The new carrier uses a 74AHCT125N to translate GP16's 3.3 V data signal to 5 V logic, a 330 Ω series resistor between buffer output and ring DIN, a 100 nF bypass capacitor near U1, and a 470 µF / 10 V bulk capacitor near the LED output.

* Pico pin 40 (VBUS, 5 V from USB) -> carrier +5 V and NeoPixel ring 5V
* Pico pin 38 (GND) -> carrier and ring common ground
* Pico GP16 (physical pin 21) -> U1 pin 2 (1A)
* U1 pin 3 (1Y) -> R1 330 Ω -> LED output DIN
* U1 pin 14 (VCC) -> +5 V; U1 pin 7 -> GND
* C1 100 nF from +5 V to GND near U1; C2 470 µF / 10 V from +5 V to GND near the LED output (positive lead to +5 V)

Use one buffer channel and confirm the IC package pinout. Check continuity before applying power and ensure the 5 V supply can handle the LED current. The KiCad carrier files are a Rev A draft and need ERC/DRC and a mechanical fit check before fabrication.

Wiring finished and Pico attached.

When you are done, attach the Pico onto the enclosure with four screws. It should look like the above picture, except your soldering will probably be _much_ nicer than mine. I posted that pic to give you mad confidence. Note that the Pico is "hanging upside down from the ceiling" of the top half of the enclosure. The Pico's green on-board LED and white BOOTSEL button should be facing _down_, so you'll be able to use them from the bottom of the device.

> [!TIP]
> The little black chip with the Raspberry Pi logo in the center of the Pico 2W board is our CPU. So, what's that big giant square metal chip, the largest component on the PCB? That's the WiFi and Bluetooth hardware! It's like a whole little radio tower for sending and receiving signals. We take advantage of it to serve the webpages used to control the LuminaBlossom. _If you don't see a big metal chip, make sure you have a Pico 2W and not a Pico 2!_

---

## 7. Final Assembly

All that's left to do is to close it up! All the electronics are self-contained in the top-half of the enclosure; the bottom half simply displays the instructions and hides our wiring. At this point, you'll probably want to [install the software](/docs/installation.md) and make sure everything's ship-shape.

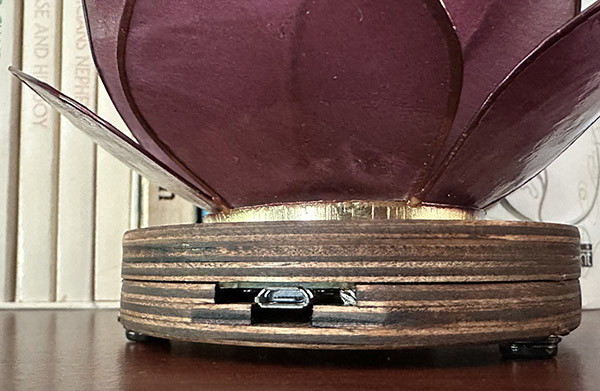
[picture p21: docs/images/assembly_final_fit.jpg]
The Pico sitting snug inside the final assembly.


Once you're happy that your wiring works, the bottom half of the enclosure attaches to the top half with three screws. Sink them until they're flush, then hide all three with little rubber feet.

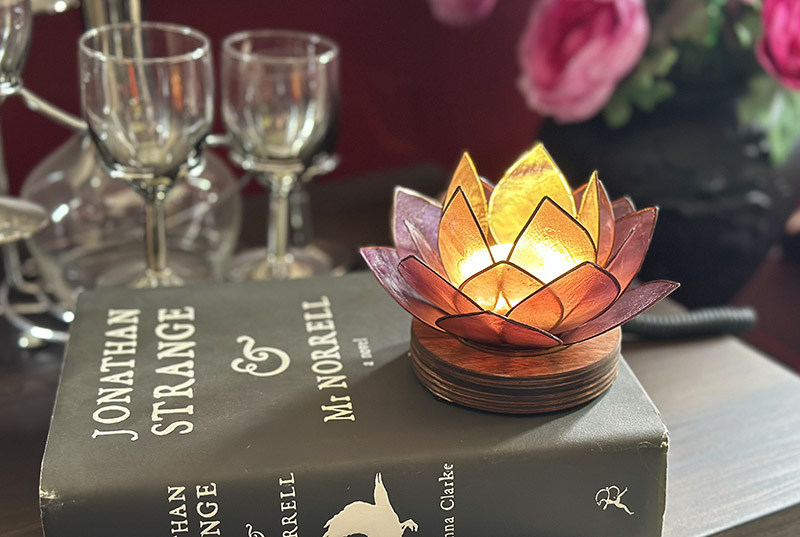
[picture p22: docs/images/assembly_finished.jpg]
The LuminaBlossom Finished Product


# Enjoy your hand-crafted wifi-enabled illuminated art display!
