LunarEchoo56/LuminaBlossom/docs/instructions.md

# Instructions: LuminaBlossom Programmable Light Display

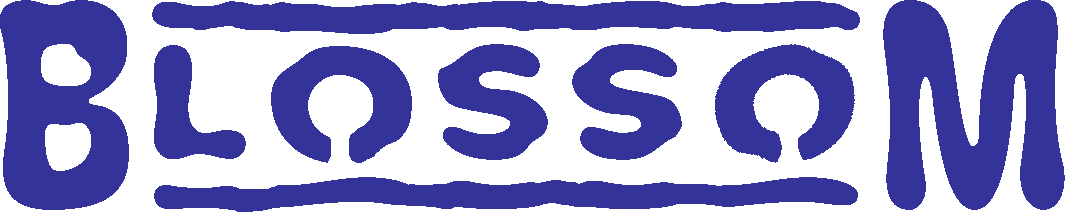
[picture p23: docs/images/luminablossom_logo.png]
LuminaBlossom Logo


## It's Time to LuminaBlossom!

May this gift bring warmth, light, peace and joy to your environment.

A brief version of these instructions are engraved onto the bottom of your LuminaBlossom. Have fun!

---

## Table of Contents

1. [Package Contents](#1-package-contents)
2. [How LuminaBlossom Works](#2-how-luminablossom-works)
3. [Setup](#3-setup)
4. [Offline Mode](#4-offline-mode)
5. [Playing Animations](#5-playing-animations)
6. [Playing Meditations](#6-playing-meditations)
7. [Factory Reset](#7-factory-reset)
8. [Troubleshooting](#8-troubleshooting)

---

# 1. Package Contents

* 1 LuminaBlossom Programmable Light Display
* 1 Micro-USB to USB-A Cable
* 1 Region-Appropriate USB-A Charging Block

Plug your LuminaBlossom in and make sure all the lights turn on. Your LuminaBlossom can be plugged directly into a wall outlet via the charging block, or it can be connected to any USB port (such as your laptop or desktop computer.)

---

# 2. How LuminaBlossom Works

Your LuminaBlossom is more than a bunch of pretty lights! Each LuminaBlossom is a little tiny computer that runs its own webserver and hosts its own webpages. That means anyone with a web browser can connect to LuminaBlossom and play with it in real-time. If you connect LuminaBlossom to your Wi-Fi, you can control it from any machine on your network.

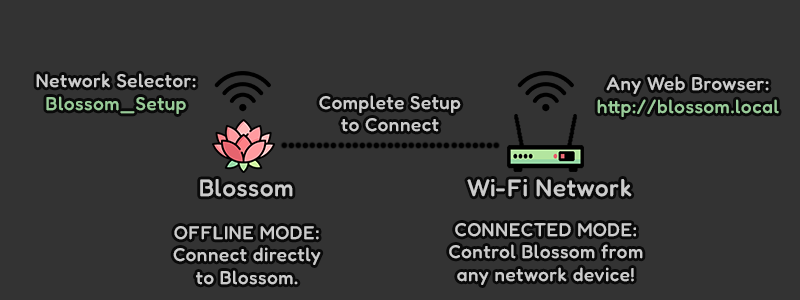
[picture p24: docs/images/instructions_connect.png]
How LuminaBlossom Works


If you don't want to give LuminaBlossom any Wi-Fi credentials, it can still be used in ["offline mode"](#4-offline-mode). When offline, the only way to control LuminaBlossom is to connect to it directly.

>[!TIP]
>You can take LuminaBlossom camping or off-grid! Even when there's no Internet or Wi-Fi nearby, you can still use offline mode to control LuminaBlossom from any device.

---

# 3. Setup

When you first power on the LuminaBlossom, it will enter *Setup Mode*. While in Setup Mode, the LuminaBlossom acts as a Wi-Fi hotspot. You can connect to it and configure it from any Wi-Fi enabled device, such as your phone or laptop.

**During Setup, the "Status" indicator on the bottom of the LuminaBlossom will slowly blink.**

1. *Connect:* Go to the Network Settings of any device - the place where you would select a Wi-Fi network. If you're anywhere near the LuminaBlossom, you will see `LuminaBlossom_Setup` as an available network. Select it and click 'Connect!'

2. *Configure:* A setup page should pop up immediately. Depending on the OS of the device you're using and its default web browser, this "captive" webpage might show up instantaneously, or it may take a moment. If it does not appear at all, open up a web browser, type `192.168.4.1` into the address bar, and press Go — the setup page will appear.

>[!TIP]
>**On iPhone/iPad:** after tapping `LuminaBlossom_Setup`, stay on the Wi-Fi settings screen and give it a few seconds — the setup sheet slides up on its own. If it doesn't, tap the `LuminaBlossom_Setup` row again, or open Safari and go to `192.168.4.1`. If iOS asks whether to keep using the network without internet, choose **"Use Without Internet"** — LuminaBlossom is a local device and never needs internet access.

3. *Credential...ize!* LuminaBlossom will display a list of nearby networks and their signal strength. Choose your network and type in the Wi-Fi password. Click `Connect to Network.`

LuminaBlossom will now reboot and attempt to connect to your network with the given credentials. If the password is correct and the network nearby, LuminaBlossom will enter Connected Mode.

**During Connected Mode, the "Status" indicator on the bottom of the LuminaBlossom will remain on.**

Once connected, point a web browser on the same wi-fi network to `http://luminablossom.local` to play animations and meditations!

---

# 4. Offline Mode

If you are nowhere near a Wi-Fi connection or want to control LuminaBlossom without using your network password, all of LuminaBlossom's features are still available! Simply connect to the `LuminaBlossom_Setup` network as described above to bring up the captive Setup page. Click on `Offline Mode` to use the animation and meditation features.

While in Offline Mode, your device won't be connected to any other Wi-Fi network.

---

# 5. Playing Animations

LuminaBlossom has 16 colorful LED lights and an additional 16 warm white LED lights arranged in a ring. The Animations editor allows you to customize the ambient lighting display.

**To Play Animations, go to http://luminablossom.local from any connected web browser. Click "Animations."**

* *Colors:* Choose the primary hue of the color LEDs and the spread of the color gradient for animations.

* *Sparkles:* Choose the primary brightness of the white LEDs and the brightness gradient for animations.

* *Flicker Animation:* Apply to an LED channel to make lights flicker between colors or brightness based on a configurable noise pattern.

* *Pulse Animation:* Apply to an LED channel to make lights cycle between colors or brightness based on a configurable sine wave pattern.

* *Spin Animation:* Apply to an LED channel to make lights rotate clockwise or counter-clockwise at a configurable speed.

Animation presets can be saved by clicking `Save Preset`. Saved presets can also be made the default on boot-up, even when LuminaBlossom is disconnected.

More information about how to configure and play animations can be found in our [Animation Guide.](/docs/animation_guide.md).

---

# 6. Playing Meditations

LuminaBlossom encourages you to be present in the moment. Its gentle ambient lights can guide you through a common breathing exercise.

**To Play Meditations, go to http://luminablossom.local from any connected web browser. Click "Meditations."**

Select your meditation duration and press `begin`. Follow the sparkles, breathing in as they fill up, holding for four seconds, and breathing out as they empty. Imagine your lungs and body are filling with a bright light. Make sure to breathe deeply, and pay attention to how your body feels.

More information about mindfulness and the meditation technique used here can be found in our [Meditations Guide.](/docs/meditations.md).

---

# 7. Factory Reset

A "Reset" button is hidden inside the LuminaBlossom, accessible via a pinhole on the bottom of the sculpture. Look for the Reset location just below the Status indicator light.

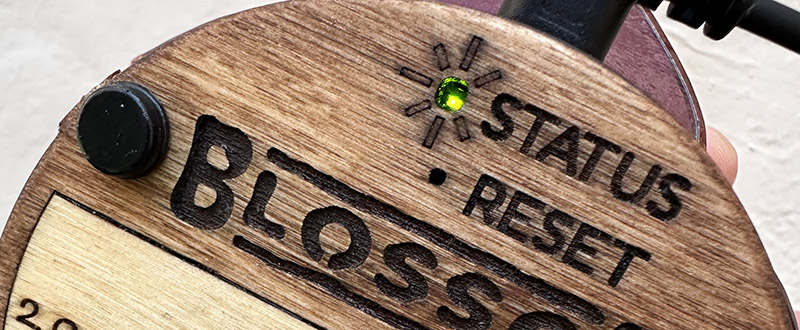
[picture p25: docs/images/instructions_status_reset.jpg]
Status Indicator and Hidden Reset Button


To initiate a factory reset (wiping all network credentials), use a paperclip to _press and hold the Reset button for 5 seconds_. You will be able to feel the button click, and during the 5-second countdown the Status light will blink rapidly.

After 5 seconds, the device will restart in Setup Mode with no Wi-Fi credentials saved.

---

# 8. Troubleshooting

* **One or More Lights are Out.** LuminaBlossom's low-power ambient display should run without fail for thousands of hours, but sometimes LEDs give out. If several are out, it indicates that a broken LED is also interrupting the data line (see [LuminaBlossom's LED Technical Details](/docs/led_technical_details.md)). The easiest fix is to replace the defective LED ring.

* **The Ring Does Not Light Up at All.** Ensure that the LEDs are set to "enabled" in the web interface. If the Status light is operating but the LED lights are dark, this indicates a bad wiring connection. Open everything up and check the connections. If the Status light is ALSO dark, LuminaBlossom is not getting power; ensure that the USB cable is plugged in and powered.

* **LuminaBlossom_Setup Does Not Appear as a Network.** If you are trying to configure the LuminaBlossom and don't see the `LuminaBlossom_Setup` network, LuminaBlossom may already be connected to something. Make sure the Status light is blinking to indicate setup mode. Try power-cycling the LuminaBlossom. If you see a solid light but wish to reconfigure the LuminaBlossom, do a [Factory Reset](#7-factory-reset).

* **The Setup Page Doesn't Pop Up on my Phone.** Some devices (especially iPhones) are picky about captive setup pages. Stay connected to `LuminaBlossom_Setup`, open a web browser, and go to `192.168.4.1` directly — the setup page is always available at that address. If your phone offers to disconnect because the network "has no internet," choose to stay connected / use without internet.

* **Cannot Connect to luminablossom.local.** Make sure LuminaBlossom is connected to the Wi-Fi by checking the Status light - if it's blinking, you'll need to re-connect it. If the light is on and you still don't see the LuminaBlossom, ensure that your devices are using the same network. Try power-cycling the LuminaBlossom to get a fresh connection. If you are using Wi-Fi extenders, note that they may not forward local webpages.

* **Please contact me with other bug reports and/or success stories!**
