LunarEchoo56/LuminaBlossom/hardware/kicad/luminablossom_carrier.kicad_pcb

## KiCad design hardware/kicad/luminablossom_carrier.kicad_pcb (2026-10-10)

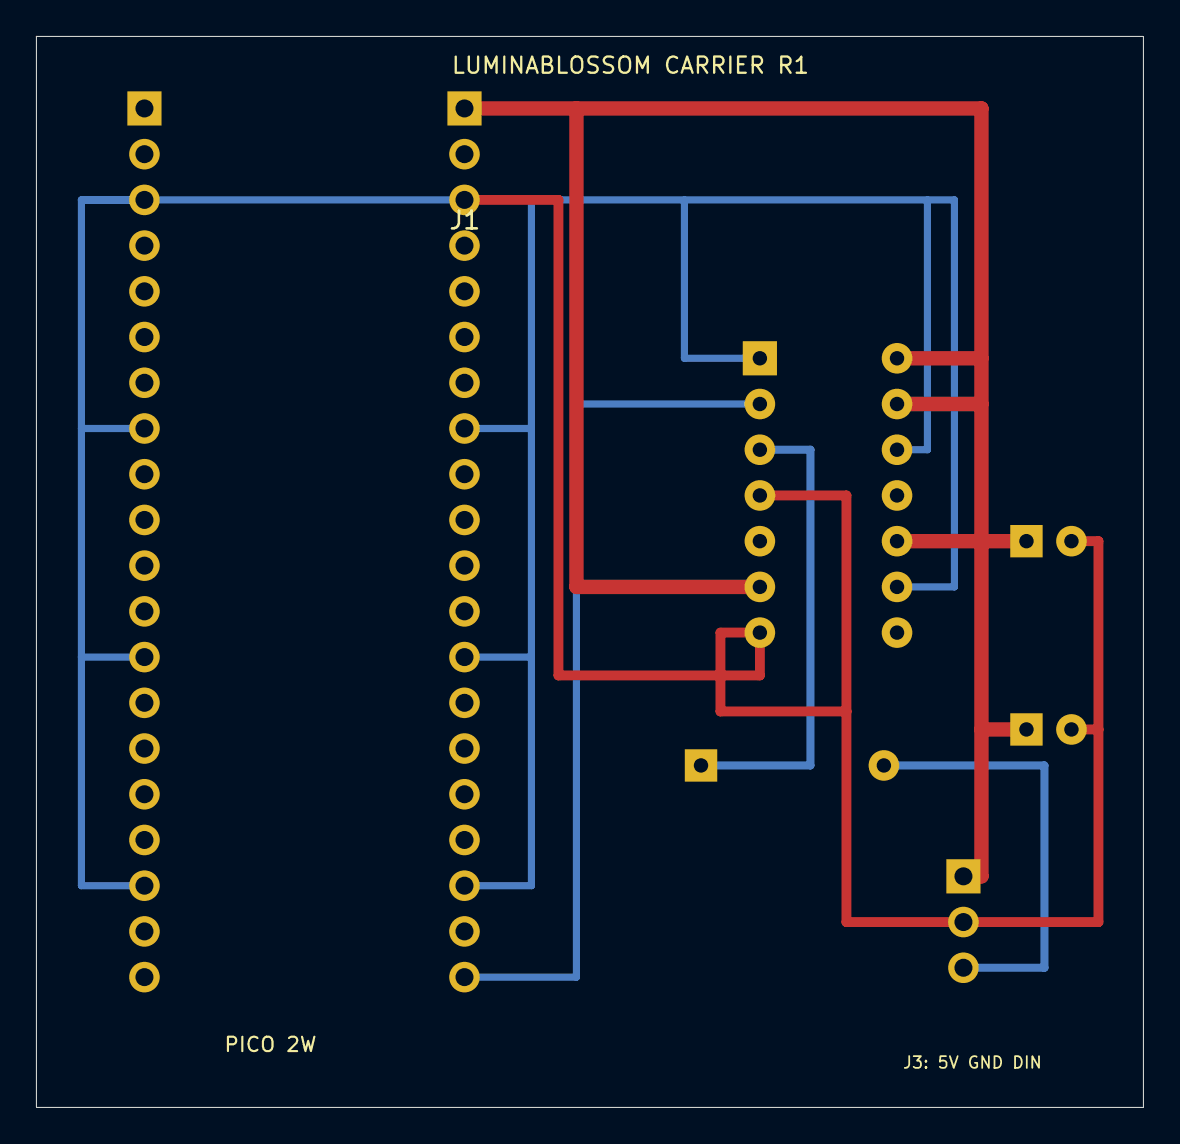
[picture p33: board luminablossom_carrier.kicad_pcb from above]

Board: 2 copper layers, 61.5 x 59.5 mm, 7 parts (0 on the bottom side), 5 nets.

Parts:
C1: 100nF; C_Disc_D5.0mm_W2.5mm_P2.50mm
C2: 470uF 10V; CP_Radial_D6.3mm_P2.50mm
J1: Pico left pins 1-20; PinSocket_1x20_P2.54mm_Vertical
J2: Pico right pins 40-21; PinSocket_1x20_P2.54mm_Vertical
J3: 5V GND DIN; PinHeader_1x03_P2.54mm_Vertical
R1: 330R; R_Axial_DIN0207_L6.3mm_D2.5mm_P10.16mm_Horizontal
U1: SN74AHCT125N; DIP-14_W7.62mm

Connections:
+5V: C1.1 (+), C2.1 (+), J2.1 (VBUS), J3.1 (+5V), U1.6 (/2OE), U1.10 (/3OE), U1.13 (/4OE), U1.14 (VCC)
GND: C1.2 (-), C2.2 (-), J1.3 (GND), J1.8 (GND), J1.13 (GND), J1.18 (GND), J2.3 (GND), J2.8 (GND), J2.13 (GND), J2.18 (GND), J3.2 (GND), U1.1 (/1OE), U1.4 (2A), U1.7 (GND), U1.9 (3A), U1.12 (4A)
LED_DATA_3V3: J2.20 (GP16), U1.2 (1A)
LED_DATA_5V: J3.3 (LED_DIN), R1.2 (B)
LED_DATA_BUF: R1.1 (A), U1.3 (1Y)
