LunarEchoo56/LuminaBlossom/src/main.cpp

// ###########################################################################
//                               LUMINABLOSSOM
//                  WiFi-Enabled Programmable Light Display
//                                July, 2026
// ###########################################################################
//
//  Project: LuminaBlossom - WiFi-Enabled Programmable Light Display
//  Description: Firmware for Raspberry Pi Pico 2W local wifi LED controller
//
//   Licensed under the Apache License, Version 2.0 (the "License");
//   you may not use this file except in compliance with the License.
//   You may obtain a copy of the License at
//
//       http://www.apache.org/licenses/LICENSE-2.0
//
//   Unless required by applicable law or agreed to in writing, software
//   distributed under the License is distributed on an "AS IS" BASIS,
//   WITHOUT WARRANTIES OR CONDITIONS OF ANY KIND, either express or implied.
//   See the License for the specific language governing permissions and
//   limitations under the License.
// ###########################################################################
//   HARDWARE SETUP
//   - Raspberry Pi Pico 2W (RP2350) microcontroller
//   - An array of SK6812 LEDs:
//     - Tested with Adafruit Neopixel 16-pixel RGBW ring
//     - Powered via 5V USB - use separate power supply for larger LED arrays
//   - Connections:
//     - Powered Micro-USB cable to Raspberry Pi Pico 2W
//     - LED data line to GP16 (Pin 21 on the Pico - far corner from USB port)
//     - LED power to VBUS (Pin 40 on the Pico) or external 5V supply
//     - LED ground to Pico GND (Pin 38, 33, 28, or 23 on the Pico)
//   NOTES ABOUT SK6812 LEDs:
//   - SK6812 expects 3.5V from the data line, but our Pico only outputs 3.3V.
//     Seems to work reliably on Adafruit's Neopixel rings.
//     Incorporate a logic-level shifter if you have issues with your specific LED array.
//   - These lights can be BRIGHT! Use the LED_BRIGHTNESS constant in led_controller.cpp
//     to cap the maximum brightness. If you'd like to run the lights at full intensity,
//     it's definitely recommended to give them their own 5V power supply.
// ###########################################################################
//   SYSTEM ARCHITECTURE
//                    ┌────────────┐
//                   (▌  BOOTSEL/  ▐)
//                   (▌Reset Button▐)
//                    └──┬─────────┘
//                  ┌────┼──────────────────────────────┐
//                  │    │       RP 2350 CPU            │
//       ┌────────┐ │ ┌──┴───────────┐ ┌──────────────┐ │
//       │  File  ├─┴─┤    CORE 0:   ├─┤    CORE 1:   │ │
//       │ System ├─┬─┤ Wifi and Web ├─┤LED Controller│ │
//       └────────┘ │ └──────┬───────┘ └───────┬──────┘ │
//                  └────────┼─────────────────┼────────┘
//                      ┌────┴─────┐     ┌─────┴────┐
//                      │Wifi Chip │     │PIO State │
//                      │          │     │ Machine  │
//                      └──────────┘     └─────┬────┘
//                       ││▲    ▼││         *  │  *
//                     Local Network      *  LEDs   *
//                                          *  *  *
// The Pico could probably manage everything on a single core, but let's show off!
// We use the dual-core to manage connections while ensuring the LED animation is unbroken.
//   Core 0: WiFi, WebServer, provisioning and monitoring factory reset button.
//   Core 1: Calculating LED animations and sending updates to them via PIO.
// The Pico comes with built-in "Programmable I/O" ("PIO") state machines.
//   These are little tiny machine-code processors with perfect timing.
//   SK6812 LEDs expect signals to come in at very specific intervals;
//   Offloading this timing to a PIO state machine frees up the main CPU. Very fancy.
//   See the led_controller.cpp file for all the details and machine code!
// ###########################################################################
//
// ###########################################################################
// ##                        MAIN.cpp - Entry Point                         ##
// ###########################################################################
//    Initializes and starts the loops for both cores.
//    Core 0 manages the main device state:
//      - MODE_PROVISIONING: Not connected to wifi. Posts the provisioning server.
//      - MODE_CONNECTED: Connected to wifi. Runs webserver and sends LED updates to core 1.
//    Hardware Reset is also handled on core 0:
//      Hold BOOTSEL button for 5 seconds in any mode to clear credentials and reboot.
//    Core 1 is dedicated to the LED controller and animations - see led_controller.cpp.

// Necessary libraries for core operation, web services, and file system management
#include <Arduino.h>        // Core Arduino library for Pico W
#include <WiFi.h>           // WiFi support for Pico W
#include <WebServer.h>      // HTTP server for handling web requests
#include <DNSServer.h>      // DNS server for handling captive portal when provisioning
#include <LEAmDNS.h>        // mDNS support for local network discovery ("luminablossom.local")
#include <LittleFS.h>       // File system for storing credentials, web pages and assets
// Project-specific headers for credentials, network requests, and LED control
#include "credentials.h"    // Load/Save WiFi credentials to LittleFS
#include "wifi_manager.h"   // Handles WiFi connection logic and provisioning
#include "web_handlers.h"   // HTTP request handlers for the web server
#include "led_controller.h" // Controls the LED animations and updates (core 1)
#include "presets.h"        // Save/Load named animation presets to LittleFS

// On-Board LED pin (Pico W uses WiFi chip LED) Used to display LuminaBlossom's connected status
#ifndef LED_BUILTIN
#define LED_BUILTIN 25
#endif

// Global server instances (used in web_handlers.h)
WebServer server(80);
DNSServer dnsServer;

// System state
enum SystemMode {
  MODE_PROVISIONING,  // AP mode: no credentials, auth failure, or network unavailable
  MODE_CONNECTED      // STA mode: fully on WiFi, WebServer running
};
SystemMode currentMode = MODE_PROVISIONING;

// Enable Serial Output to Watch debug messages on your serial monitor!
bool serialDebug = true;  // Usually false for production builds

// LED state tracking (If the web handler needs to look at the state of the LED)
bool ledState = true;

// Deferred reboot - Allows messages to complete before restarting system
bool rebootPending = false;
unsigned long rebootAt = 0;
// Schedule a reboot after a specified delay (in milliseconds)
void scheduleReboot(unsigned long delayMs) {
  rebootPending = true;
  rebootAt = millis() + delayMs;
}

// Factory reset button state (Uses the built-in Pico 2W BOOTSEL button)
unsigned long bootselPressStart = 0;
bool bootselPressedLastLoop = false;
const unsigned long FACTORY_RESET_HOLD_TIME = 5000;  // 5 seconds

// ###########################################################################
// ##                   MAIN.cpp - Core 0 Setup and Loop                    ##
// ###########################################################################

void setup() {
  // Initialize Serial Output (if active) and give it some time to start up
  if (serialDebug) {
    Serial.begin(115200);
    delay(1000);  // Allow time for the serial monitor to connect
    Serial.println("\n=================================");
    Serial.println("LuminaBlossom - Programmable Light Display");
    Serial.println("=================================\n");
  }

  // Initialize the on-board LED pin for status indication
  pinMode(LED_BUILTIN, OUTPUT);
  digitalWrite(LED_BUILTIN, LOW);

  // Initialize the file system (LittleFS)
  // Report status to serial if enabled
  if (!LittleFS.begin()) {
    if (serialDebug) Serial.println("! LittleFS mount failed. Run: pio run --target uploadfs");
  } else {
    if (serialDebug) Serial.println("+ LittleFS mounted");
  }

  // Start the boot animation right away, before any (slow) WiFi work below.
  // This loads the user's saved default preset from LittleFS and hands it to
  // the LED controller on Core 1. On a fresh device with no saved presets,
  // the built-in "Warm Flame" config fills the role automatically.
  applyDefaultPreset();

  // Try to load saved WiFi credentials from the file system
  String savedSSID, savedPassword;
  int timeoutSeconds = 20;
  if (loadCredentials(savedSSID, savedPassword)) {
    if (serialDebug) Serial.println("Found saved credentials, attempting connection...");

    if (connectToWiFi(savedSSID, savedPassword, timeoutSeconds)) {
      // Successful connection! Set mode and turn indicator LED on
      currentMode = MODE_CONNECTED;
      digitalWrite(LED_BUILTIN, HIGH);

      // Start mDNS responder for local network discovery: "luminablossom.local"
      if (MDNS.begin("luminablossom")) {
        if (serialDebug) Serial.println("+ mDNS responder started. Hostname: luminablossom.local");
        MDNS.addService("http", "tcp", 80);
      } else {
        if (serialDebug) Serial.println("! mDNS setup failed. Check network configuration.");
      }

      // Set up web server routes for connected mode
      setupConnectedRoutes();

      if (serialDebug) {
        Serial.println("\n=================================");
        Serial.println("+ CONNECTED TO WIFI");
        Serial.print("Network: ");
        Serial.println(WiFi.SSID());
        Serial.print("IP: ");
        Serial.println(WiFi.localIP());
        Serial.println("Hostname: luminablossom.local");
        Serial.println("=================================\n");
      }

      // If connected, setup is finished!
      return;
    }

    // If we've reached this part of the code, it means we've successfully loaded
    // credentials but failed to connect to the WiFi network. Possibilities:
    // WL_CONNECT_FAILED means password was rejected. Credentials are definitively wrong.
    // Any other failure (timeout, WL_NO_SSID_AVAIL) means the network was unreachable.
    //   - Possibly a temporary outage. Keep credentials and wait for a power cycle.
    //   - Possibly a new setup. Keep credentials but start provisioning mode.
    // Either way, this code will fall through to start the provisioning AP.
    if (WiFi.status() == WL_CONNECT_FAILED) {
      // Password was rejected. Clear credentials.
      if (serialDebug) Serial.println("x Authentication failed -- clearing credentials");
      clearCredentials();
    } else {
      if (serialDebug) {
        Serial.println("x Network unreachable -- credentials preserved, starting provisioning AP");
        Serial.println("  (Power cycle will retry stored credentials automatically)");
      }
    }
  } else {
    if (serialDebug) Serial.println("No saved credentials found");
  }

  // Failed to connect to WiFi, so we fire up the provisioning access point:
  currentMode = MODE_PROVISIONING;
  startProvisioningAP(dnsServer);
  setupProvisioningRoutes();
  digitalWrite(LED_BUILTIN, HIGH);
}

void loop() {
  // Core 0 main loop: Handles WiFi, web server, and factory reset button
  // #################### Factory Reset Button Handling ####################
  bool bootselPressed = BOOTSEL;

  // Check if reset button was pressed and start the timer if so.
  if (bootselPressed && !bootselPressedLastLoop) {
    bootselPressStart = millis();
    if (serialDebug) Serial.println("\nBOOTSEL button pressed - hold for 5 seconds to factory reset...");
  }

  // If the reset button is being held, flash the LED and check the timer
  if (bootselPressed && bootselPressedLastLoop) {
    unsigned long holdDuration = millis() - bootselPressStart;
    digitalWrite(LED_BUILTIN, (millis() / 100) % 2); // Flash onboard LED every 100 ms

    // Output countdown to serial monitor if debug is enabled
    if (serialDebug) {
      static unsigned long lastCountdown = 0;
      if (millis() - lastCountdown > 1000) {
        int secondsLeft = (FACTORY_RESET_HOLD_TIME - holdDuration) / 1000;
        if (secondsLeft >= 0) {
            Serial.print("Factory reset in ");
            Serial.print(secondsLeft + 1);
            Serial.println(" seconds...");
          }
        lastCountdown = millis();
      }
    }

    // Trigger factory reset if the button has been held long enough
    if (holdDuration >= FACTORY_RESET_HOLD_TIME) {
      if (serialDebug) {
        Serial.println("\n=================================");
        Serial.println("FACTORY RESET TRIGGERED");
        Serial.println("=================================");
      }

      // Rapid confirmation blink right before reset:
      for (int i = 0; i < 10; i++) {
        digitalWrite(LED_BUILTIN, HIGH);
        delay(50);
        digitalWrite(LED_BUILTIN, LOW);
        delay(50);
      }

      // Wipe credentials and reboot!
      clearCredentials();
      if (serialDebug) Serial.println("Rebooting to provisioning mode...");
      delay(500);
      rp2040.reboot();
    }
  }

  // Reset the hold timer if the reset button has been released
  if (!bootselPressed && bootselPressedLastLoop) {
    unsigned long holdDuration = millis() - bootselPressStart;
    if (holdDuration < FACTORY_RESET_HOLD_TIME) {
      if (serialDebug) Serial.println("BOOTSEL button released - factory reset cancelled");
    }
  }

  // Store button state for next loop
  bootselPressedLastLoop = bootselPressed;

  // Handle deferred reboot if scheduled
  if (rebootPending && millis() >= rebootAt) {
    rp2040.reboot();
  }

  // #################### Main Mode Handling ####################
  if (currentMode == MODE_PROVISIONING) {
    // While provisioning, answer DNS queries. processNextRequest() handles at
    // most ONE UDP packet per call, but devices doing captive-portal detection
    // (especially iOS) fire bursts of lookups at once — drain a few per loop
    // so probe DNS never has to wait for extra loop iterations.
    for (int i = 0; i < 4; i++) {
      dnsServer.processNextRequest();
    }
    // Blink LED slowly to indicate provisioning mode
    if (!bootselPressed) {
      static unsigned long lastBlink = 0;
      if (millis() - lastBlink > 2000) {
        digitalWrite(LED_BUILTIN, !digitalRead(LED_BUILTIN));
        lastBlink = millis();
      }
    }
  } else {  // MODE_CONNECTED
    // While connected, update mDNS and monitor WiFi connection
    MDNS.update();

    // WiFi watchdog: if the connection drops (e.g. router reboot, brief outage),
    // the WebServer and lwIP stack won't recover on their own. After a 30-second
    // grace period we reboot. The device reconnects in ~10s and re-advertises
    // luminablossom.local via mDNS. Core 1 / LEDs are unaffected during the wait.
    static bool          wifiWasLost = false;
    static unsigned long wifiLostAt  = 0;
    if (WiFi.status() != WL_CONNECTED) {
      if (!wifiWasLost) {
        wifiWasLost = true;
        wifiLostAt  = millis();
        if (serialDebug) Serial.println("! WiFi disconnected - rebooting in 30s if not restored");
      } else if (millis() - wifiLostAt >= 30000UL) {
        if (serialDebug) Serial.println("! WiFi lost for 30s - rebooting to reconnect");
        delay(100);
        rp2040.reboot();
      }
    } else {
      wifiWasLost = false;
    }

    // Ensure the built-in LED is on when connected and BOOTSEL is not pressed
    if (!bootselPressed) {
      digitalWrite(LED_BUILTIN, HIGH);
    }
  }

  // Handle incoming web requests, regardless of mode (provisioning or connected):
  server.handleClient();
}

// ###########################################################################
// ##                   MAIN.cpp - Core 1 Setup and Loop                    ##
// ###########################################################################

void setup1() {
  // Core 1 immediately initializes the LED array on startup:
  initLEDs();
}

void loop1() {
  // Core 1 main loop: Creates new anim frames and sends them to the LED array
  updateLEDs();
}
