LunarEchoo56/LuminaBlossom/(commit log)

2026-10-10 Initial commit: LuminaBlossom programmable LED light display
    Firmware, documentation, enclosure files and build journal for a
    Wi-Fi-enabled Raspberry Pi Pico 2W light display with a browser
    control surface.
2026-10-10 Fix documentation links, asset references and firmware banner
    Repoints the installation guide at the canonical repository, removes
    dead media embeds, corrects broken cross-references and anchors, and
    tidies the firmware header block.
    [main.cpp]
2026-10-10 Improve README visuals, document design assets, and add BOM
    [BOM.csv]
2026-10-10 Add draft KiCad carrier board and native schematic
    [BOM.csv, luminablossom_carrier.kicad_pcb, luminablossom_carrier.kicad_sch]
2026-10-10 Add KiCad 9 source export check
2026-10-10 Fix footprint instance path syntax for KiCad
    [luminablossom_carrier.kicad_pcb]
2026-10-10 Fix KiCad CLI SVG export mode in source check
